yAya-yns/HourCache/dev_components/sensorsToServer/LoRa_Web_Server_Combined.ino

/*********
  Rui Santos
  Complete project details at https://RandomNerdTutorials.com/esp32-lora-sensor-web-server/

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
  The above copyright notice and this permission notice shall be included in all
  copies or substantial portions of the Software.
*********/

// Import Wi-Fi library
#include <WiFi.h>
#include "ESPAsyncWebServer.h"

#include <SPIFFS.h>

//Libraries for LoRa
#include <SPI.h>
#include <LoRa.h>

//Libraries for OLED Display
#include <Wire.h>
#include <Adafruit_GFX.h>
#include <Adafruit_SSD1306.h>

//CHANGE TO GRYOSCOPE AND PRESSURE PAD SENSOR
//Libraries for BME280
#include <Adafruit_Sensor.h>
#include <Adafruit_BME280.h>

// Libraries to get time from NTP Server
#include <NTPClient.h>
#include <WiFiUdp.h>

//define the pins used by the LoRa transceiver module
#define SCK 5
#define MISO 19
#define MOSI 27
#define SS 18
#define RST 14
#define DIO0 26

//433E6 for Asia
//866E6 for Europe
//915E6 for North America
#define BAND 915E6

//OLED pins
#define OLED_SDA 4
#define OLED_SCL 15 
#define OLED_RST 16
#define SCREEN_WIDTH 128 // OLED display width, in pixels
#define SCREEN_HEIGHT 64 // OLED display height, in pixels

//CHANGE WITH OUR SENSORS
//BME280 definition
#define SDA 21
#define SCL 13

TwoWire I2Cone = TwoWire(1);
Adafruit_BME280 bme;

//packet counter
int readingID = 0;

int counter = 0;
String LoRaMessage = "";

// TIME, GRYO, STATE
float temperature = 0;
float humidity = 0;
float pressure = 0;

// Replace with your network credentials
const char* ssid     = "REPLACE_WITH_YOUR_SSID";
const char* password = "REPLACE_WITH_YOUR_PASSWORD";

// Define NTP Client to get time
WiFiUDP ntpUDP;
NTPClient timeClient(ntpUDP);

// Variables to save date and time
String formattedDate;
String day;
String hour;
String timestamp;


// Initialize variables to get and save LoRa data
//int rssi;
//String loRaMessage;
//String temperature;
//String humidity;
//String pressure;
//String readingID;

// Create AsyncWebServer object on port 80
AsyncWebServer server(80);

Adafruit_SSD1306 display(SCREEN_WIDTH, SCREEN_HEIGHT, &Wire, OLED_RST);

//need this for website
// Replaces placeholder with DHT values
String processor(const String& var){
  //Serial.println(var);
  if(var == "TEMPERATURE"){
    return temperature;
  }
  else if(var == "HUMIDITY"){
    return humidity;
  }
  else if(var == "PRESSURE"){
    return pressure;
  }
  else if(var == "TIMESTAMP"){
    return timestamp;
  }
  else if (var == "RRSI"){
    return String(rssi);
  }
  return String();
}

//Initialize OLED display
void startOLED(){
  //reset OLED display via software
  pinMode(OLED_RST, OUTPUT);
  digitalWrite(OLED_RST, LOW);
  delay(20);
  digitalWrite(OLED_RST, HIGH);

  //initialize OLED
  Wire.begin(OLED_SDA, OLED_SCL);
  if(!display.begin(SSD1306_SWITCHCAPVCC, 0x3c, false, false)) { // Address 0x3C for 128x32
    Serial.println(F("SSD1306 allocation failed"));
    for(;;); // Don't proceed, loop forever
  }
  display.clearDisplay();
  display.setTextColor(WHITE);
  display.setTextSize(1);
  display.setCursor(0,0);
  display.print("LORA SENDER");
}

void startBME(){
  I2Cone.begin(SDA, SCL, 100000); 
  bool status1 = bme.begin(0x76, &I2Cone);  
  if (!status1) {
    Serial.println("Could not find a valid BME280_1 sensor, check wiring!");
    while (1);
  }
}

//Initialize LoRa module
void startLoRA(){
  int counter;
  //SPI LoRa pins
  //I GUESS CHANGE THE PINS HERE?
  SPI.begin(SCK, MISO, MOSI, SS);
  //setup LoRa transceiver module
  LoRa.setPins(SS, RST, DIO0);

  while (!LoRa.begin(BAND) && counter < 10) {
    Serial.print(".");
    counter++;
    delay(500);
  }
  if (counter == 10) {
    // Increment readingID on every new reading
    Serial.println("Starting LoRa failed!"); 
  }
  Serial.println("LoRa Initialization OK!");
  display.setCursor(0,10);
  display.clearDisplay();
  display.print("LoRa Initializing OK!");
  display.display();
  delay(2000);
}

void connectWiFi(){
  // Connect to Wi-Fi network with SSID and password
  Serial.print("Connecting to ");
  Serial.println(ssid);
  WiFi.begin(ssid, password);
  while (WiFi.status() != WL_CONNECTED) {
    delay(500);
    Serial.print(".");
  }
  // Print local IP address and start web server
  Serial.println("");
  Serial.println("WiFi connected.");
  Serial.println("IP address: ");
  Serial.println(WiFi.localIP());
  display.setCursor(0,20);
  display.print("Access web server at: ");
  display.setCursor(0,30);
  display.print(WiFi.localIP());
  display.display();
}

//CHANGE FOR OUR SENSORS
void getReadings(){
  state = //change for readings of state using gyro. just do math here //bme.readTemperature();
  time_start = // idk how to do time... KELVIN has some code for that //bme.readHumidity();
  time_stop = //bme.readPressure() / 100.0F;
  time_curr = ????
}

void updateStatesTimes(){
  state_1 = 
  state_2 = 
  state
}

// Function to get date and time from NTPClient
void getTimeStamp() {
  while(!timeClient.update()) {
    timeClient.forceUpdate();
  }
  // The formattedDate comes with the following format:
  // 2018-05-28T16:00:13Z
  // We need to extract date and time
  formattedDate = timeClient.getFormattedDate();
  Serial.println(formattedDate);

  // Extract date
  int splitT = formattedDate.indexOf("T");
  day = formattedDate.substring(0, splitT);
  Serial.println(day);
  // Extract time
  hour = formattedDate.substring(splitT+1, formattedDate.length()-1);
  Serial.println(hour);
  timestamp = day + " " + hour;
}

void setup() { 
  // Initialize Serial Monitor
  Serial.begin(115200);
  startOLED();
  startBME();
  startLoRA();
  connectWiFi();
  
  if(!SPIFFS.begin()){
    Serial.println("An Error has occurred while mounting SPIFFS");
    return;
  }
  // Route for root / web page
  server.on("/", HTTP_GET, [](AsyncWebServerRequest *request){
    request->send(SPIFFS, "/index.html", String(), false, processor);
  });
  server.on("/Current State", HTTP_GET, [](AsyncWebServerRequest *request){
    request->send_P(200, "text/plain", state.c_str());
  });
  server.on("/Time in State ", HTTP_GET, [](AsyncWebServerRequest *request){
    request->send_P(200, "text/plain", time_curr.c_str());
  });
  server.on("/timestamp", HTTP_GET, [](AsyncWebServerRequest *request){
    request->send_P(200, "text/plain", timestamp.c_str());
  });
  server.on("/winter", HTTP_GET, [](AsyncWebServerRequest *request){
    request->send(SPIFFS, "/winter.jpg", "image/jpg");
  });
  server.on("/State 1", HTTP_GET, [](AsyncWebServerRequest *request){
    request->send_P(200, "text/plain", timestamp.c_str());
  });
  server.on("/State 2", HTTP_GET, [](AsyncWebServerRequest *request){
    request->send_P(200, "text/plain", timestamp.c_str());
  });
  server.on("/State 3", HTTP_GET, [](AsyncWebServerRequest *request){
    request->send_P(200, "text/plain", timestamp.c_str());
  });
  server.on("/State 4", HTTP_GET, [](AsyncWebServerRequest *request){
    request->send_P(200, "text/plain", timestamp.c_str());
  });
  server.on("/State 5", HTTP_GET, [](AsyncWebServerRequest *request){
    request->send_P(200, "text/plain", timestamp.c_str());
  });
  server.on("/State 6", HTTP_GET, [](AsyncWebServerRequest *request){
    request->send_P(200, "text/plain", timestamp.c_str());
  });
  // Start server
  server.begin();
  
  // Initialize a NTPClient to get time
  timeClient.begin();
  // Set offset time in seconds to adjust for your timezone, for example:
  // GMT +1 = 3600
  // GMT +8 = 28800
  // GMT -1 = -3600
  // GMT 0 = 0
  timeClient.setTimeOffset(0);
}

void loop() {
  getReadings();
  updateStatesTimes();
  delay(10000);
}
