yAya-yns/HourCache/dev_components/wifi_tester/wifi_tester_v7/wifi_tester_v7.ino

#include <WiFi.h>
#include "RTClib.h"
#include "ESPAsyncWebServer.h"
#include <TFT_eSPI.h>
#include <Wire.h>
#include <string> 
#include <SPIFFS.h>

#define uS_TO_S_FACTOR 1000000ULL  /* Conversion factor for micro seconds to seconds */
#define TIME_TO_SLEEP  5        /* Time ESP32 will go to sleep (in seconds) */

const char* ssid = "CHANGE THIS TO NETWORK NAME";
const char* password = "CHANGE THIS TO NETWORK PASSWORD";

AsyncWebServer server(80);

int counter = 0;

TFT_eSPI tft = TFT_eSPI(135, 240); // Invoke custom library
RTC_DS1307 rtc;

char daysOfTheWeek[7][12] = {"Sunday", "Monday", "Tuesday", "Wednesday", "Thursday", "Friday", "Saturday"};

String hour_string;
String minute_string;
String second_string;
String finalString;

String processor(const String& var){
  //Serial.println(var);
  if(var == "HOUR"){
    return hour_string;
  }
  else if(var == "MINUTE"){
    return minute_string;
  }
  else if(var == "SECOND"){
    return second_string;
  }
  return String();
}

void setup(){
  Serial.begin(115200);
  WiFi.begin(ssid, password);

  if (! rtc.begin()) {
    Serial.println("Couldn't find RTC");
    while (1);
  }
   // Initialize SPIFFS
  if(!SPIFFS.begin(true)){
    Serial.println("An Error has occurred while mounting SPIFFS");
    return;
  }
  while (WiFi.status() != WL_CONNECTED){
    delay(1000);
    Serial.println("Connecting to wifi...");
  }

  finalString = "Hour: " + hour_string + "\nMinute: " + minute_string + "\nSecond: " + second_string;  
  Serial.println(finalString);
  server.on("/index", HTTP_GET, [](AsyncWebServerRequest *request){
    request->send(SPIFFS, "/index.html", String(), false, processor);
  });
  server.on("/hour", HTTP_GET, [](AsyncWebServerRequest *request){
    request->send_P(200, "text/plain", hour_string.c_str());
  });
  server.on("/minute", HTTP_GET, [](AsyncWebServerRequest *request){
    request->send_P(200, "text/plain", minute_string.c_str());
  });
  server.on("/second", HTTP_GET, [](AsyncWebServerRequest *request){
    request->send_P(200, "text/plain", second_string.c_str());
  });
  server.on("/winter", HTTP_GET, [](AsyncWebServerRequest *request){
    request->send(SPIFFS, "/winter.jpg", "image/jpg");
  });
  server.begin();

   if (! rtc.isrunning()) {
   Serial.println("RTC is NOT running!");
   // following line sets the RTC to the date & time this sketch was compiled
   rtc.adjust(DateTime(F(__DATE__), F(__TIME__)));
   // This line sets the RTC with an explicit date & time, for example to set
   // January 21, 2014 at 3am you would call:
   // rtc.adjust(DateTime(2014, 1, 21, 3, 0, 0));
 }

  tft.init();
  tft.setRotation(1);
  tft.fillScreen(TFT_BLACK);
  tft.setTextSize(2);
  tft.setTextColor(TFT_GREEN);
  tft.setCursor(0, 0);
  tft.setTextDatum(MC_DATUM);
  tft.setTextSize(1);

  esp_sleep_enable_timer_wakeup(TIME_TO_SLEEP * uS_TO_S_FACTOR); //enable sleep every 5 seconds
}

void loop(){
 DateTime now = rtc.now();

 tft.fillScreen(TFT_BLACK);
 tft.drawString("Current Time is", tft.width() / 2, tft.height() / 2 - 16);
 String curr_time = String(now.hour()) + String(":") + String(now.minute()) + String(":") + String(now.second());
 hour_string = String(now.hour());
 minute_string = String(now.minute());
 second_string = String(now.second());
 finalString = "Hour: " + hour_string + "\nMinute: " + minute_string + "\nSecond: " + second_string;  
 Serial.println(curr_time);
 
 tft.drawString(curr_time, (tft.width() / 2), (tft.height() / 2 + 16)); 
 delay(1000);
 ++counter;

 if (counter == 5){
  tft.drawString("Going to sleep...", tft.width() / 2, tft.height() / 2);
  delay(500);
  esp_deep_sleep_start();  
}
}
//I think you just put in http://#IP ADDRESS#/result and it should show hello world?
