yAya-yns/HourCache/dev_components/arduino_test/accelerometer_interrupt/accelerometer_interrupt.ino

#include <Wire.h>

//#define I2C_SDA 21
//#define I2C_SCL 22
const int interrupt_receiver = 15;

// register addresses

#define Reg_THRESH_ACT 0x24
#define Reg_THRESH_INACT 0x25
#define Reg_TIME_INACT 0x26
#define Reg_INT_ENABLE 0x2E
#define Reg_INT_MAP 0x2F
// register values
#define THRESH_ACT 0x04
#define THRESH_INACT 0 oh
#define TIME_INACT 0
#define INT_ENABLE 0x10
#define INT_MAP 0x00
#define ADXL345 0x53// The ADXL345 sensor I2C address

int isActivated;  // Outputs
void setup(){
  Serial.begin(115200); // Initiate serial communication for printing the results on the Serial monitor
  pinMode(interrupt_receiver,INPUT);
  Wire.begin();
  
  Wire.beginTransmission(ADXL345);
  Wire.write(0x2D);
  Wire.write(8);
  Wire.endTransmission();
  delay(10);

  Wire.beginTransmission(ADXL345);
  Wire.write(0x31);
  Wire.write(1);
  Wire.endTransmission();
  delay(10);

  Wire.beginTransmission(ADXL345);
  Wire.write(0x24);
  Wire.write(50);
  Wire.endTransmission();
  delay(10);

  Wire.beginTransmission(ADXL345);
  Wire.write(0x27);
  Wire.write(240);
  Wire.endTransmission();
  delay(10);

  Wire.beginTransmission(ADXL345);
  Wire.write(0x2F);
  Wire.write(0);
  Wire.endTransmission();
  delay(10);

  Wire.beginTransmission(ADXL345);
  Wire.write(0x2E);
  Wire.write(64);
  Wire.endTransmission();
  delay(10);

}

void loop() { 
  isActivated = digitalRead(interrupt_receiver);
//  if (isActivated == 1){
  Serial.println(isActivated);
}



//void setup() {
//  Serial.begin(115200); // Initiate serial communication for printing the results on the Serial monitor
//  pinMode(interrupt_receiver,INPUT);
//  
//  Wire.begin(); // Initiate the Wire library
//  // Set ADXL345 in measuring mode
//  Wire.beginTransmission(ADXL345); // Start communicating with the device 
//  Wire.write(Reg_THRESH_ACT); // Enable Activation
//  Wire.write(THRESH_ACT); 
//  Wire.endTransmission();
//  delay(10);
//
//  Wire.beginTransmission(ADXL345); // Start communicating with the device 
//  Wire.write(Reg_TIME_INACT); // Enable Activation
//  Wire.write(TIME_INACT); 
//  Wire.endTransmission();
//  delay(10);
//
//  Wire.beginTransmission(ADXL345);
//  Wire.write(Reg_INT_ENABLE); // Enable INT
//  Wire.write(INT_ENABLE); 
//  Wire.endTransmission();
//  delay(10);
//
//  Wire.beginTransmission(ADXL345);
//  Wire.write(Reg_INT_MAP); // Enable INT_MAP
//  Wire.write(INT_MAP); 
//  Wire.endTransmission();
//  delay(10);
//}
