yAya-yns/HourCache/dev_components/arduino_test/blinking_LED_test/blinking_LED_test.ino

// the setup function runs once when you press reset or power the board
void setup() {
  // initialize digital pin LED_BUILTIN as an output.
  pinMode(15, OUTPUT);
}

// the loop function runs over and over again forever
void loop() {
  digitalWrite(15, HIGH);   // turn the LED on (HIGH is the voltage level)
  delay(1000);                       // wait for a second
  digitalWrite(15, LOW);    // turn the LED off by making the voltage LOW
  delay(1000);                       // wait for a second
}
