yAya-yns/HourCache/(commit log)

2021-03-06 added gitignore, interrupt code untested
2021-03-08 Add files via upload
    Code to upload sensor data to the webserver. untested
2021-03-20 testing interrupts on arduino
2021-04-08 adding acclerometer interrupt code
2021-04-12 interrupt to wake up sleeping ESP
